djboris9/bfh_physik2/soundtracker/pcb_layout.pdf

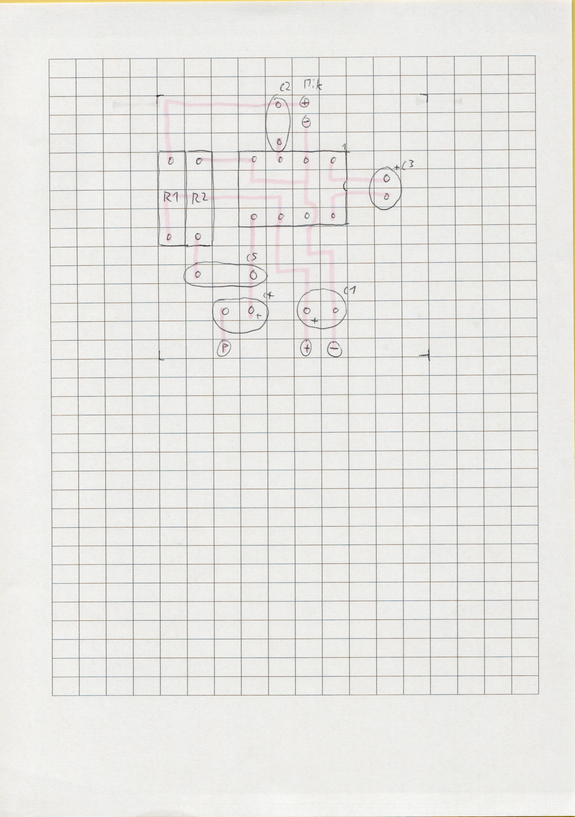
[picture p7: page 1]
