djboris9/bfh_physik2/soundtracker/soundtracker.sch

## KiCad design soundtracker/soundtracker.sch (2017-03-12)

Schematic: soundtracker.sch

Parts:
C1: 47uF; CP_Radial_D4.0mm_P1.50mm
C2, C5: 47nF; C_Disc_D3.0mm_W1.6mm_P2.50mm
C3: 10uF; CP_Radial_D4.0mm_P1.50mm
C4: 22uF; CP_Radial_D4.0mm_P1.50mm
MCE-101: Microphone; Pin_Header_Straight_1x02_Pitch2.00mm
P1: CONN_01X03
R1: 10k; R_Axial_DIN0309_L9.0mm_D3.2mm_P5.08mm_Vertical
R2: 10; R_Axial_DIN0309_L9.0mm_D3.2mm_P5.08mm_Vertical
U1: LM386; DIP-8_W7.62mm
