djboris9/bfh_physik2/prescaler_test/div16.pdf

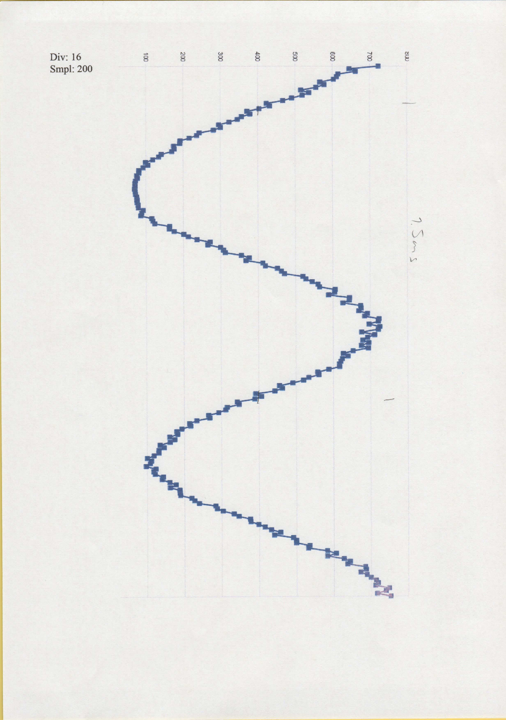
[picture p8: page 1]
