djboris9/bfh_physik2/prescaler_test/div32.pdf

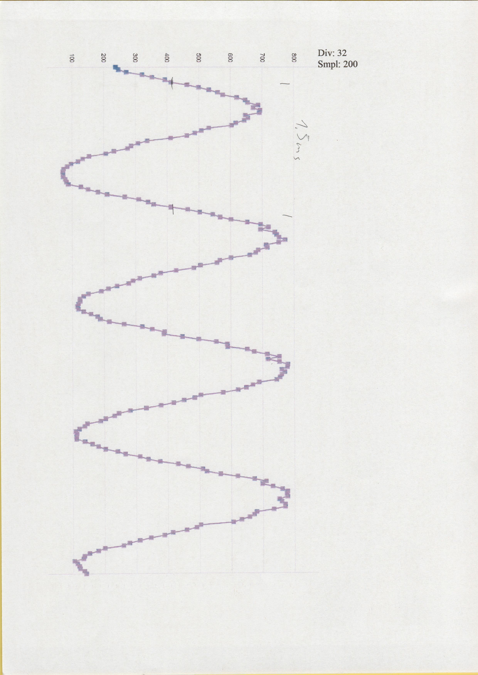
[picture p9: page 1]
