djboris9/bfh_physik2/prescaler_test/div64.pdf

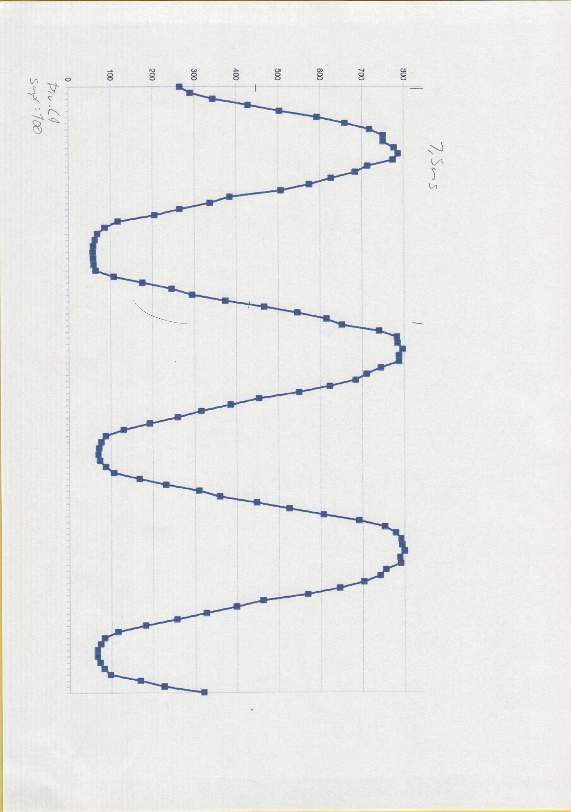
[picture p10: page 1]
