djboris9/bfh_physik2/prog.c

#include <avr/io.h>
#include <stdio.h>
#include <util/delay.h>
#include <math.h>
#include "prog.h"
#include "uart.h"

/*
 * 0.343mm per microsecond (timing unit)
 */
void adc_init(void) {
	ADMUX   = _BV(REFS0); // Set AVcc as reference
	ADCSRA  = _BV(ADPS2); // Prescaler: 16MHz/16 = 1 MHz (= 1us)
	ADCSRA |= _BV(ADEN);  // ADC Enable

	(void) adc_read(0);   // Dummy read
}

inline uint16_t adc_read(uint8_t chan) {
	ADMUX = (ADMUX & ~(0x1F)) | (chan & 0x1F); // Select read channel
	ADCSRA |= _BV(ADSC);                       // Start conversion

	loop_until_bit_is_clear(ADCSRA, ADSC);     // Busy wait for completion
	return ADCW;
}

// Initialize 16-Bit timer
void timer1_init(void) {
	TCCR1B = _BV(CS10); // Prescaler: 16MHz/1 = 16 MHz
	TCNT1 = 0;          // Initialize to zero
}

inline void timer1_reset(void) {
	TCNT1 = 0;
}

inline uint16_t timer1_get(void) {
	return TCNT1;
}

#define BREAKOUT_LEVEL 600
#define RESET_DISTMETER\
	inp_0_ref = 0; \
	inp_1_ref = 0; \
	inp_2_ref = 0; \
	inp_0_set = 0; \
	inp_1_set = 0; \
	inp_2_set = 0; \
	timing = 0;

// Microseconds to milimeter
double msToMM(double val) {
	return val / 41;
}

void printAngle(uint16_t inp0, uint16_t inp1, uint16_t inp2) {
	double angleShort, angleLong, resAngle;

	double inp0mm = msToMM(inp0);
	double inp1mm = msToMM(inp1);
	double inp2mm = msToMM(inp2);

	if (inp1 < 10) {
		angleShort = 42;
		angleLong = 42;

		resAngle = 42;
	} else if (inp0 < 10) {
		angleShort = atan(inp1mm/75);
		angleLong = atan(inp2mm/150);

		resAngle = atan(inp2mm/150);
	} else if (inp2 < 10) {
		angleShort = atan(inp1mm/75);
		angleLong = atan(inp0mm/150);

		resAngle = atan(inp0mm/150);
	}

	resAngle = (angleShort+angleLong)/2;
	resAngle = (360/(3*M_PI))*resAngle;

	// Print
	stdout = &uart_output;
//	fprintf(stdout, "Result: inp0mm=%f inp1mm=%f inp2mm=%f\n", inp0mm, inp1mm, inp2mm);
	fprintf(stdout, "Result: %f\n", resAngle);
}

void distMeter(void) {
	uint16_t inp_0_ref;
	uint16_t inp_1_ref;
	uint16_t inp_2_ref;
	uint8_t inp_0_set;
	uint8_t inp_1_set;
	uint8_t inp_2_set;
	uint8_t timing;

	RESET_DISTMETER

	for (;;) {
		uint16_t inp_0 = adc_read(0);
		uint16_t inp_1 = adc_read(1);
		uint16_t inp_2 = adc_read(2);

		if (inp_0 >= BREAKOUT_LEVEL && !inp_0_set) {
			// inp_0 breakout
			if (!timing) {
				timing = 1;
				timer1_reset();
			}

			inp_0_ref = timer1_get();
			inp_0_set = 1;

		} else if (inp_1 >= BREAKOUT_LEVEL && !inp_1_set) {
			// inp_1 breakout
			if (!timing) {
				timing = 1;
				timer1_reset();
			}

			inp_1_ref = timer1_get();
			inp_1_set = 1;
		} else if (inp_2 >= BREAKOUT_LEVEL && !inp_2_set) {
			// inp_2 breakout
			if (!timing) {
				timing = 1;
				timer1_reset();
			}

			inp_2_ref = timer1_get();
			inp_2_set = 1;
		}

		if (inp_0_set && inp_1_set && inp_2_set) {
			// Process and display result
			stdout = &uart_output;
			fprintf(stdout, "TimeDiffRaw: inp0=%i inp1=%i inp2=%i\n", inp_0_ref, inp_1_ref, inp_2_ref);

			// Pretty result
			printAngle(inp_0_ref, inp_1_ref, inp_2_ref);

			// Reset variables to default
			RESET_DISTMETER

			// Sleep for 2s
			_delay_ms(2000);
			fprintf(stdout, "Ready\n");
		}
	}
}

int main(void) {
	// Initializations
	uart_init();
	adc_init();
	timer1_init();

	stdout = &uart_output;
	puts("Initialized!");

	// Start distMeter
	distMeter();

	return 0;
}
