djboris9/bfh_physik2/(commit log)

2017-03-12 other files
    [soundtracker.sch]
2017-06-04 Add prescaler PDFs and a PCB layout PDF
